ZeekiChen/Violent-fan-v2.0/README.md

# Violent-fan-v2.0
2S无刷暴力风扇  
2023年6月10日  
更新固件程序，解决偶尔启动失败的问题
