ZeekiChen/Violent-fan-v2.0/HARDWARE/violent fan-v2.0-SchDoc.pdf

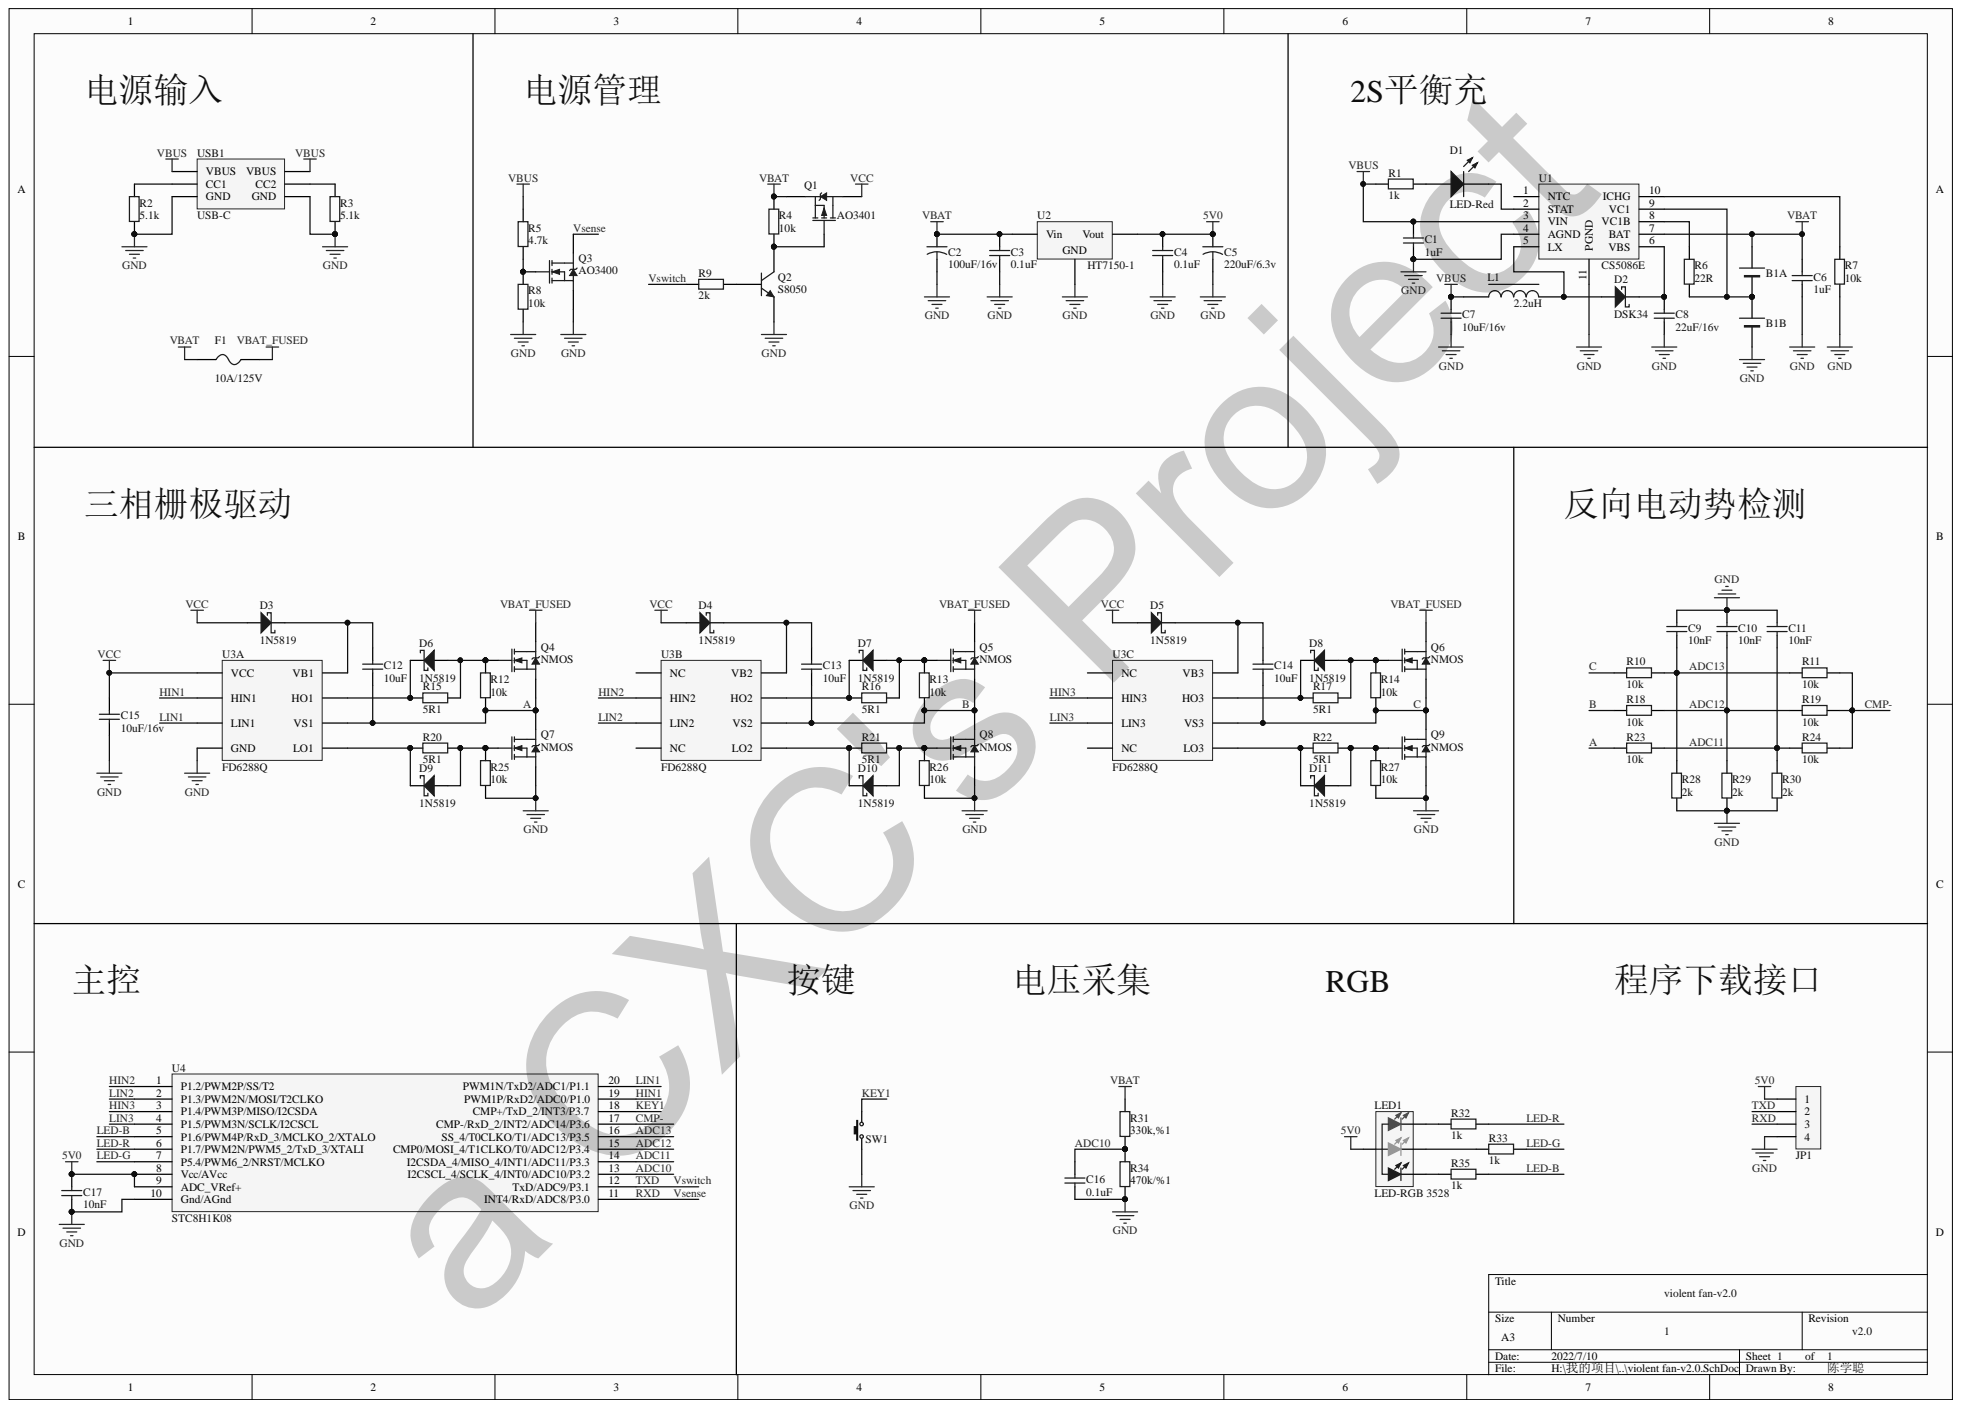
[picture p4: page 1]
