ZeekiChen/Violent-fan-v2.0/3DMODEL/风扇后盖.SLDPRT

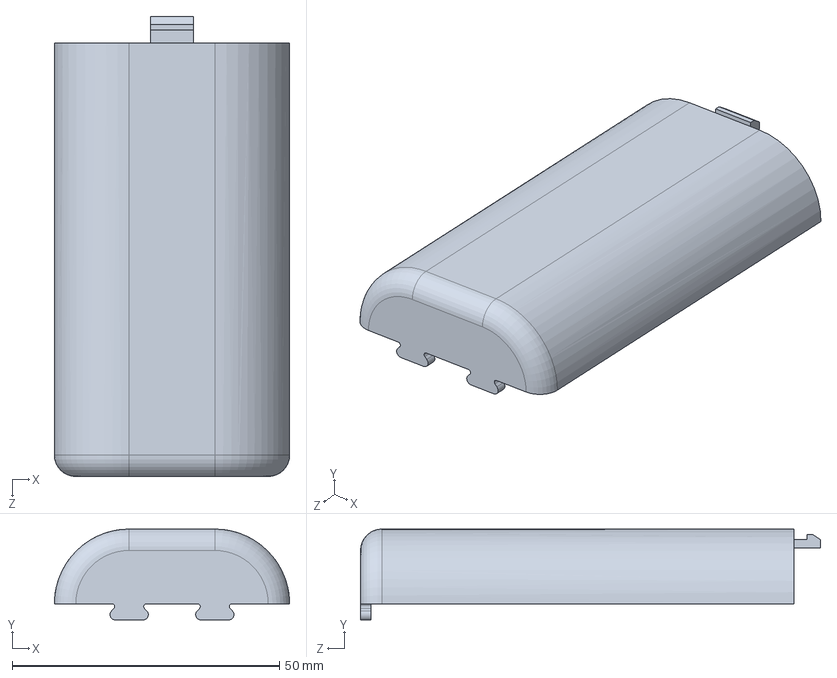
[picture p1: CAD file, 2023-05-30]
3DMODEL/风扇后盖.SLDPRT
44.0 x 17.0 x 86.0 mm
