ZeekiChen/Violent-fan-v2.0/3DMODEL/风扇外壳.SLDPRT

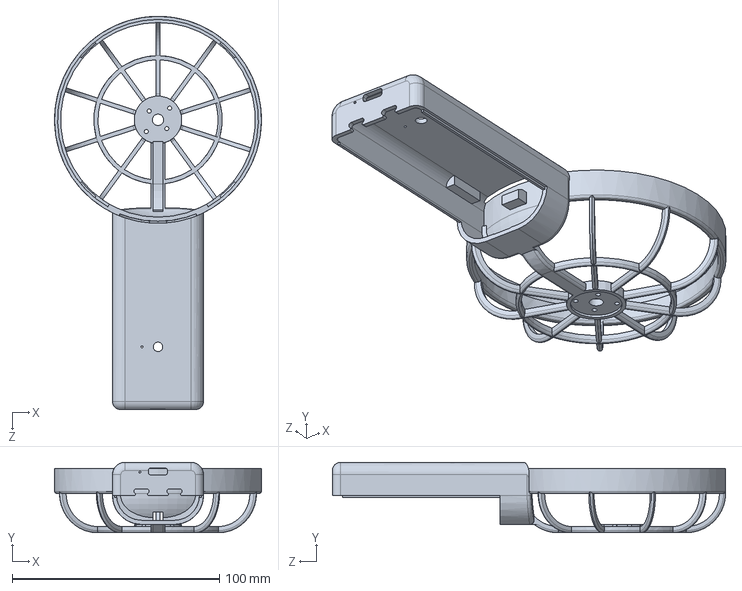
[picture p2: CAD file, 2023-05-30]
3DMODEL/风扇外壳.SLDPRT
100.0 x 34.0 x 190.0 mm
