ZeekiChen/Violent-fan-v2.0/3DMODEL/风扇前盖.SLDPRT

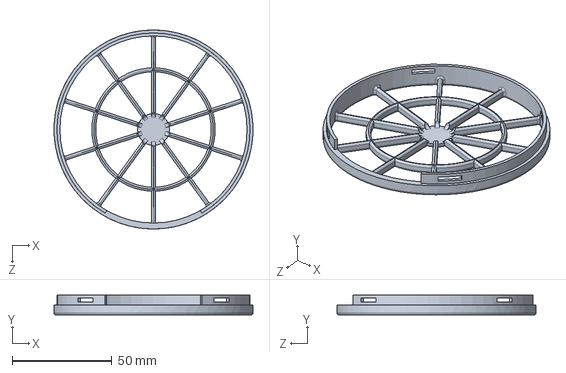
[picture p3: CAD file, 2023-05-30]
3DMODEL/风扇前盖.SLDPRT
100.0 x 10.0 x 100.0 mm
