ZeekiChen/Violent-fan-v2.0/(list of files, cad)

Other CAD files:
3DMODEL/风扇前盖.STL
3DMODEL/风扇后盖.STL
3DMODEL/风扇外壳.STL
